JAGUARAVI/STMProject/hardware/README.md

# ESWCap Rev C.1 hardware

This directory contains the KiCad source for the Rev C carrier with the
accuracy-plan changes applied (**Rev C.1**, see `docs/accuracy-plan.md`):
USB-only power, 3.3 V relays, true 4-wire C/R, the corrected J8 bias header,
and the H1–H6 accuracy changes.

## Status (2026-11-13)

- **Schematic:** Rev C + accuracy plan H1–H6. ERC-clean (0 errors, 0 warnings).
  - H1 J2-13 (PA7, OPAMP1 sense) moved FL → `MUXR_COM`
  - H2 `MUXR_EN` moved J2-17 (PB2) → J1-17 (PB15)
  - H3 `VBUF` also on J2-17 (PB2, OPAMP3 VINM0) for the PGA stage
  - H4 R20 100k → 1k; H5 D1 BAT54S → BAV199; H6 R33 1M → 10M
  - PWR_FLAGs excluded from BOM/board
- **PCB:** `kicad/Project.kicad_pcb`, 111 × 85 mm, 2 layers, **fully routed**.
  DRC: 0 unconnected, 0 clearance/short/hole errors, schematic parity clean;
  45 silkscreen-only warnings. Critical analog nets are hand-routed and locked;
  the rest is Freerouting + targeted fixes. How it was built:
  `scripts/README.md`.
  - Ground: B.Cu plane + F.Cu pour, stitched by ~318 vias, with **no-pour
    cutouts** under J5/SH divider/U9/U10, the VCAP node, and the TIA input (P2)
  - TIA guard: F.Cu `VBIAS` pour around the U1A summing node (P1)
  - Footprint fixes: C1 and J5/J6 courtyards/silkscreen now match the real
    bodies (they were drawn around the pads only)
- **Fab outputs:** `fab/Project-gerbers.zip` (`fab/gerbers/`), drill + map,
  `fab/Project-pos.csv`, `fab/Project-bom.csv`, schematic PDF/SVG,
  `fab/Project-pcb-front.pdf` / `-back.pdf`, `fab/Project-3d-top.png`.
  **Not yet reviewed by a person — review before ordering.**
- `wip/Project-revC-routing-baseline.kicad_pcb` is the old pre-review baseline,
  kept for reference only. Do not fabricate it.

Open `kicad/Project.kicad_pro` with KiCad 10. The project-local libraries
(`eswcap.kicad_sym`, `eswcap.pretty/`) are included; the schematic will not
resolve symbols/footprints without them.

## Rev C circuit summary

- **Power:** USB-C VBUS → module D4 → VDD5V → module ME6231A33M3G LDO → +3.3 V.
  J3-3/4 (`VDD5V`) are NC on the carrier. No 5 V carrier rail. Only Vbias
  (0–20 V) is external, on J6.
- **Relays:** K1/K2 = Omron **G6S-2 DC3** (3 V coils) on +3.3 V. D4/D5
  flyback cathodes, C10/C15, and coil high side are on +3V3.
- **DUT:** J5 is 4-pin, ordered **FH, SH, SL, FL**. R-mode is true 4-wire
  Kelvin; `SL` has a 100 kΩ series resistor (R40) into U1B.
- **C-mode 4-terminal sense:** 10 M/1 M divider on `SH` (R38/R39), compensated
  by C21 10 pF across the top leg and C20 100 pF across the bottom leg. The
  divider is buffered by the **internal STM32 OPAMP3** (no second LMC6482).
  U9 isolates the `SH → R20 → VN_SENSE` branch when K1 is off; U10 connects
  `SH_DIV` to `VN_SENSE` when K1 is off. U10 is controlled by PC4
  (`C_MODE_SW`, active low).
- **R20 / D2:** R20 = 100 kΩ; D2 = BAV199 (low-leakage clamp).
- **J8 bias-control header:**

| Pin | Signal | Module pin | Note |
| --- | --- | --- | --- |
| 1 | `BIAS_SET` | PA4 / J2-10 | TIM3_CH2 PWM, R34 1 k + C16 10 µF |
| 2 | `BIAS_EN` | PA15 / J1-10 | GPIO, R35 10 k pulldown |
| 3 | `BIAS_MON` | **PA8 / J1-15** | ADC5_IN1, R36 1 k + C17 100 nF |
| 4 | GND | — | — |
| 5 | `+3V3` | J4 | future module <50 mA |
| 6 | `BIAS_UART_TX` | PC10 / J1-9 | USART3_TX |
| 7 | `BIAS_UART_RX` | PC11 / J1-8 | USART3_RX |
| 8 | GND | — | — |

- **PA0 is `DRIVE` / COMP1_OUT** (firmware fix of 2026-11-12). PA8 is now free
  and carries `BIAS_MON`. PC4 is the U10 control output.
- **J5 pin order:** 1 FH, 2 SH, 3 SL, 4 FL. Use 1–2 and 3–4 links for a 2-wire
  DUT.

## BOM

`fab/Project-bom.csv` is generated from the schematic. It contains 88 physical
parts, 46 grouped lines and 3 PWR_FLAGs. The only new orderable part type is
J8 (1×8 2.54 mm header) and J5 (4-pin 5.08 mm terminal block); K1/K2 are
G6S-2 DC3. See the CSV for the complete list.

## What is deliberately not here

- The second LMC6482 was removed: it is not available. The C-mode SH divider
  now uses the internal OPAMP3.
- The PCB is not final. It must be regenerated and rerouted after the
  schematic is frozen. The WIP baseline has the pre-U9/U10 netlist and must
  not be fabricated.
- The OLED/button additions proposed in the integration-plan review are not
  part of this revision.
