JAGUARAVI/STMProject/docs/circuit/ESWCap-circuit-diagrams.pdf

# 68nF 1 2 C1

# J2 WeAct P2

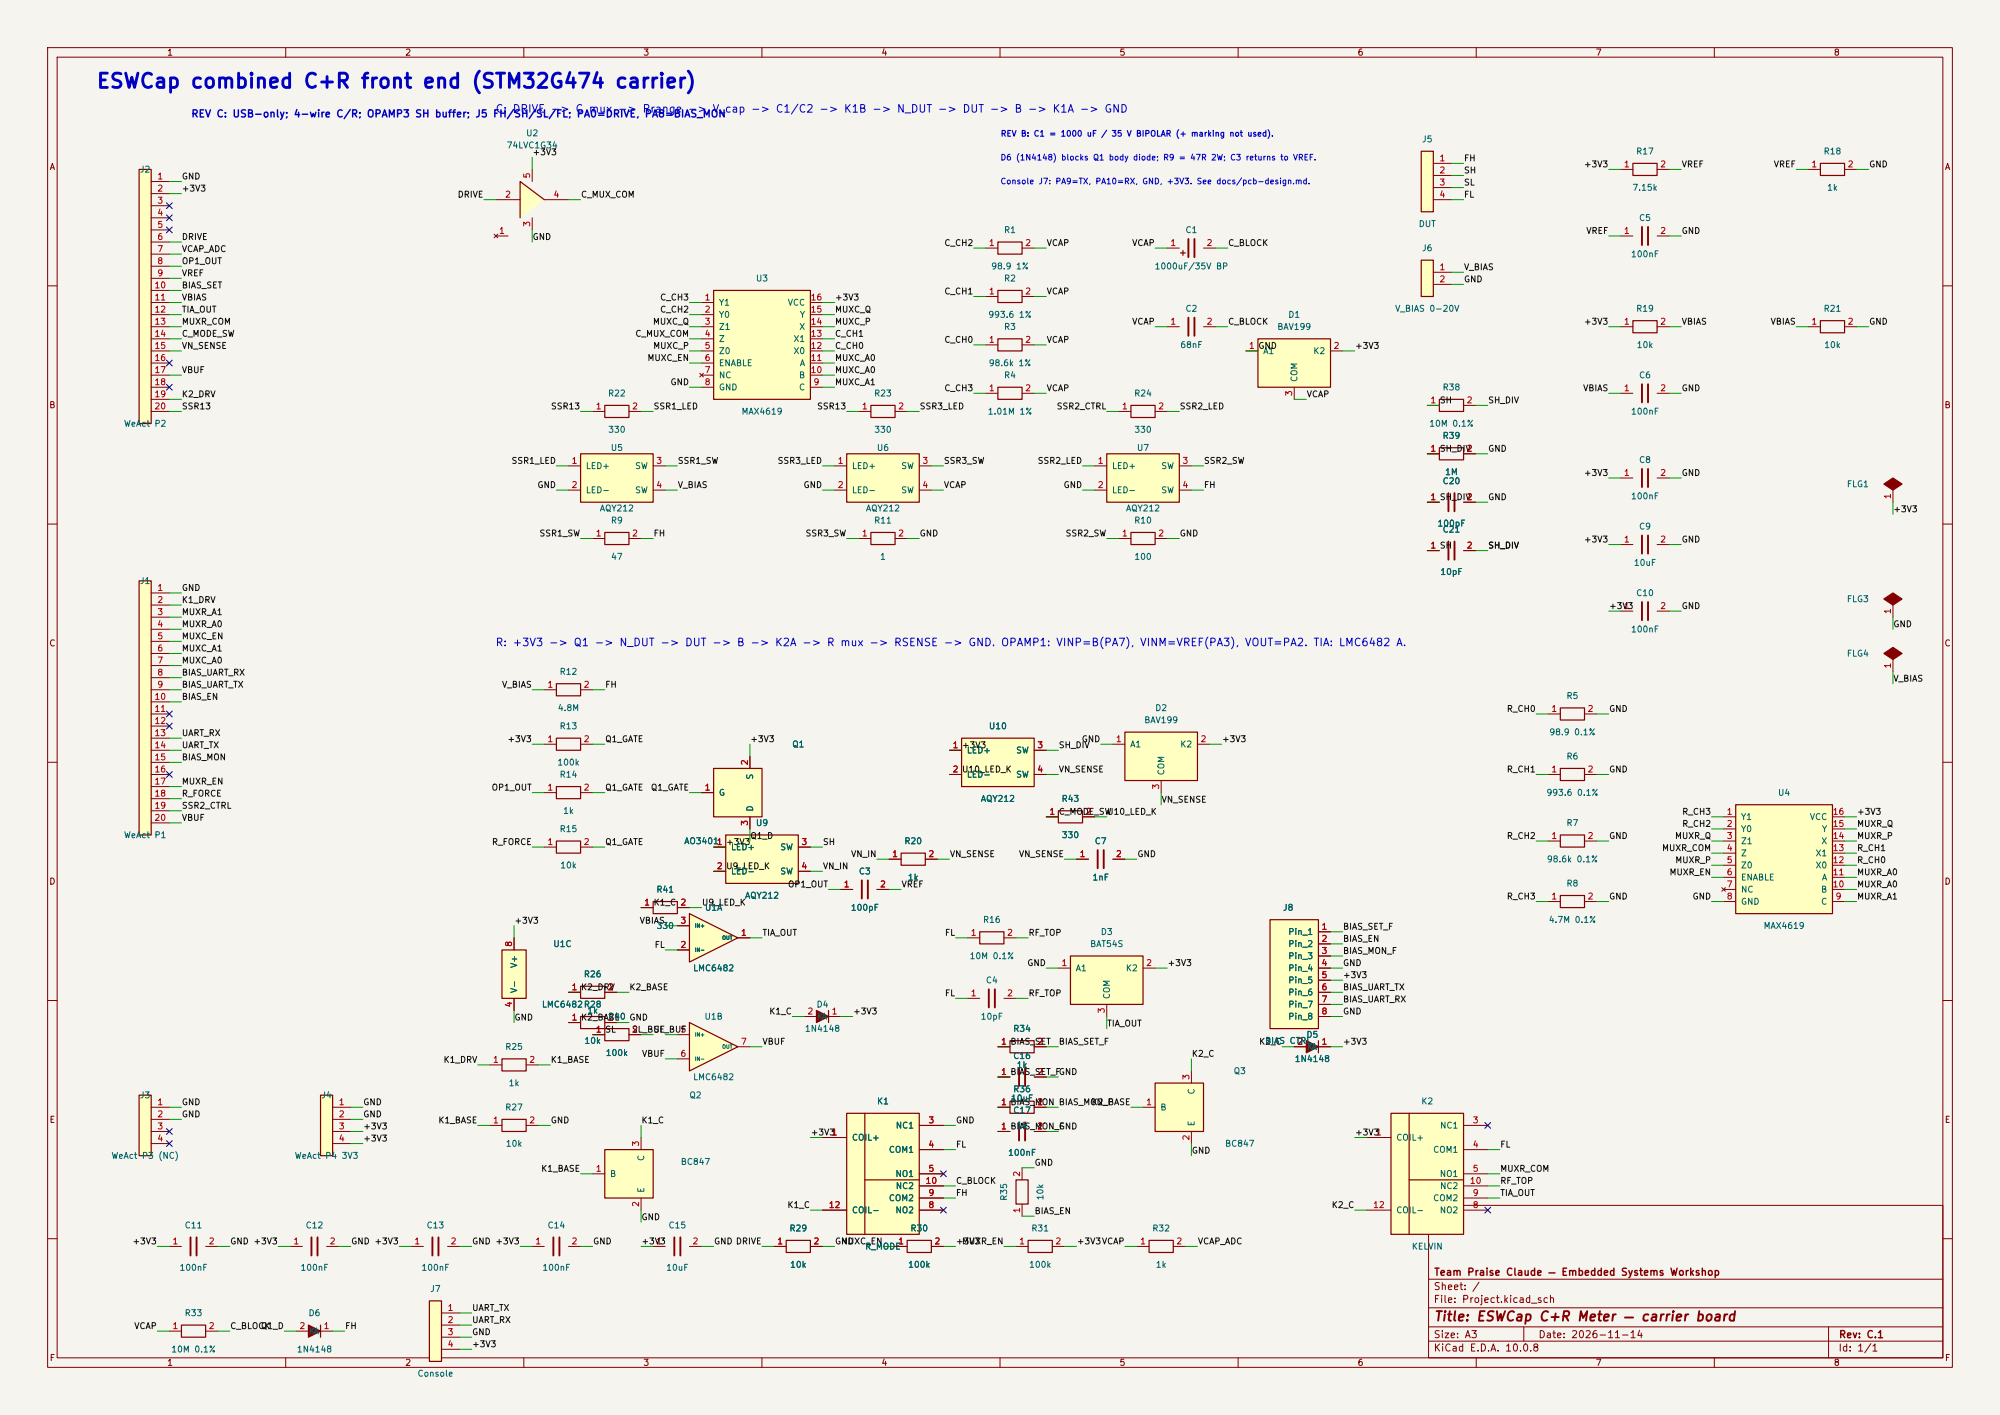
[picture p1: page 7]

ESWCap combined C+R front end (STM32G474 carrier)

REV C: USB-only; 4-wire C/R; OPAMP3 SH buffer; J5 FH/SH/SL/FL; PA0=DRIVE, PA8=BIAS_MON

C: DRIVE -> C mux -> Rrange -> V_cap -> C1/C2 -> K1B -> N_DUT -> DUT -> B -> K1A -> GND

Console J7: PA9=TX, PA10=RX, GND, +3V3. See docs/pcb-design.md. D6 (1N4148) blocks Q1 body diode; R9 = 47R 2W; C3 returns to VREF. REV B: C1 = 1000 uF / 35 V BIPOLAR (+ marking not used).

SSR3_LED MUXC_A1 R: +3V3 -> Q1 -> N_DUT -> DUT -> B -> K2A -> R mux -> RSENSE -> GND. OPAMP1: VINP=B(PA7), VINM=VREF(PA3), VOUT=PA2. TIA: LMC6482 A.

Team Praise Claude — Embedded Systems Workshop
Sheet: /
File: Project.kicad_sch
Title: ESWCap C+R Meter — carrier board
KiCad E.D.A. 10.0.8
