JAGUARAVI/STMProject/hardware/fab/Project-3d-top.png

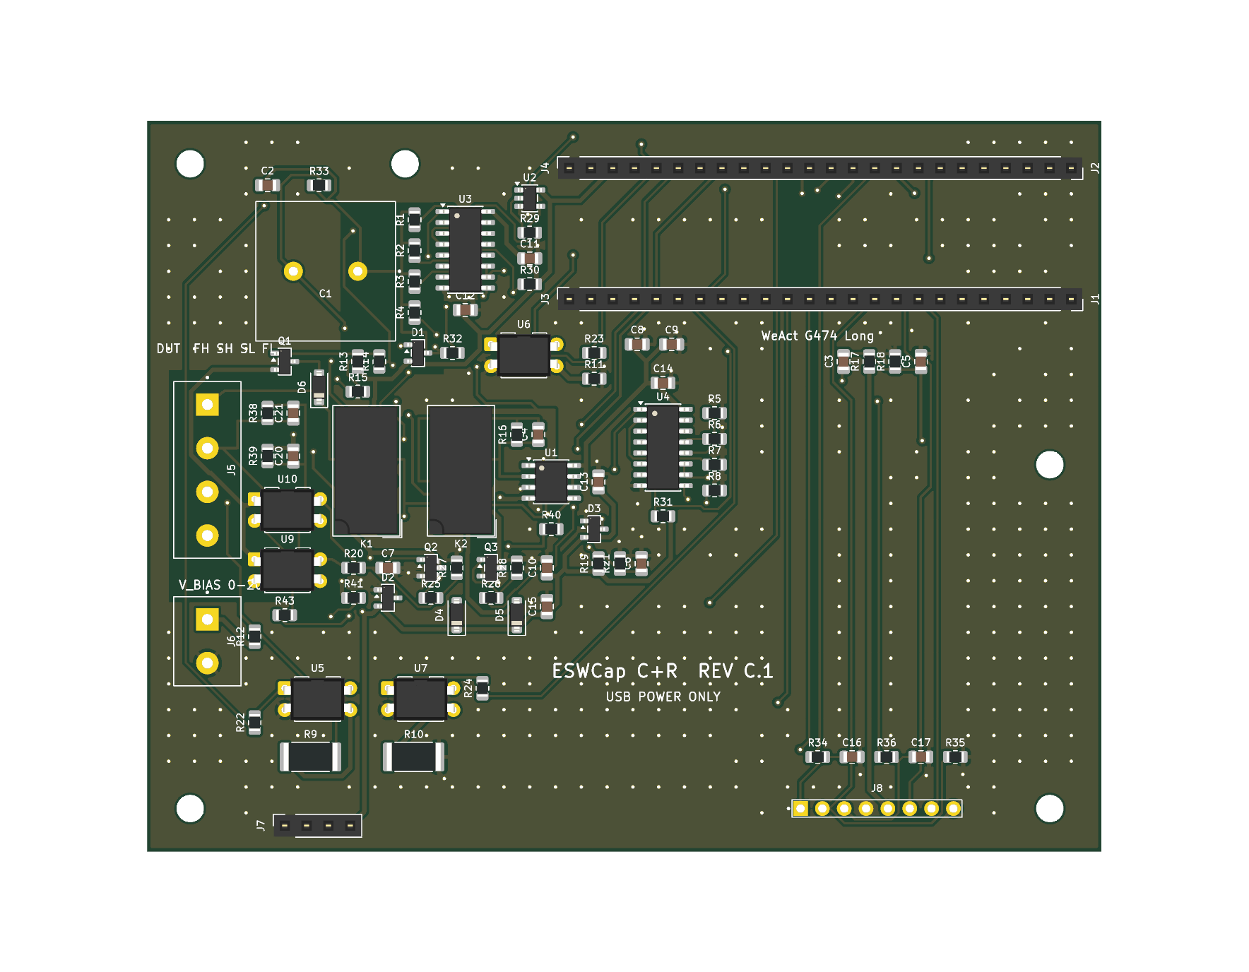
hardware/fab/Project-3d-top.png
