JAGUARAVI/STMProject/hardware/fab/Project-bom.csv

Refs | Value | Footprint | MPN | Qty
C1 | 1000uF/35V BP | eswcap:C_Radial_D16_P7.5 |  | 1
C2 | 68nF | eswcap:C_0805_2012Metric |  | 1
C3,C20 | 100pF | eswcap:C_0805_2012Metric |  | 2
C4,C21 | 10pF | eswcap:C_0805_2012Metric |  | 2
C5,C6,C8,C10-C14,C17 | 100nF | eswcap:C_0805_2012Metric |  | 9
C7 | 1nF | eswcap:C_0805_2012Metric |  | 1
C9,C15,C16 | 10uF | eswcap:C_0805_2012Metric |  | 3
D1,D2 | BAV199 | eswcap:SOT-23 |  | 2
D3 | BAT54S | eswcap:SOT-23 |  | 1
D4-D6 | 1N4148 | eswcap:D_SOD-123 |  | 3
J1 | WeAct P1 | eswcap:PinSocket_1x20_P2.54mm_Vertical |  | 1
J2 | WeAct P2 | eswcap:PinSocket_1x20_P2.54mm_Vertical |  | 1
J3 | WeAct P3 (NC) | eswcap:PinSocket_1x04_P2.54mm_Vertical |  | 1
J4 | WeAct P4 3V3 | eswcap:PinSocket_1x04_P2.54mm_Vertical |  | 1
J5 | DUT | eswcap:TerminalBlock_4P_5.08 |  | 1
J6 | V_BIAS 0-20V | eswcap:TerminalBlock_2P_5.08 |  | 1
J7 | Console | eswcap:PinSocket_1x04_P2.54mm_Vertical |  | 1
J8 | BIAS CTRL | eswcap:PinHeader_1x08_P2.54mm_Vertical |  | 1
K1 | R_MODE | eswcap:Relay_DPDT_Omron_G6S-2 | G6S-2 DC3 | 1
K2 | KELVIN | eswcap:Relay_DPDT_Omron_G6S-2 | G6S-2 DC3 | 1
Q1 | AO3401 | eswcap:SOT-23 |  | 1
Q2,Q3 | BC847 | eswcap:SOT-23 |  | 2
R1 | 98.9 1% | eswcap:R_0805_2012Metric |  | 1
R2 | 993.6 1% | eswcap:R_0805_2012Metric |  | 1
R3 | 98.6k 1% | eswcap:R_0805_2012Metric |  | 1
R4 | 1.01M 1% | eswcap:R_0805_2012Metric |  | 1
R5 | 98.9 0.1% | eswcap:R_0805_2012Metric |  | 1
R6 | 993.6 0.1% | eswcap:R_0805_2012Metric |  | 1
R7 | 98.6k 0.1% | eswcap:R_0805_2012Metric |  | 1
R8 | 4.7M 0.1% | eswcap:R_0805_2012Metric |  | 1
R9 | 47 | eswcap:R_2512_6332Metric |  | 1
R10 | 100 | eswcap:R_2512_6332Metric |  | 1
R11 | 1 | eswcap:R_0805_2012Metric |  | 1
R12 | 4.8M | eswcap:R_0805_2012Metric |  | 1
R13,R30,R31,R40 | 100k | eswcap:R_0805_2012Metric |  | 4
R14,R18,R20,R25,R26,R32,R34,R36 | 1k | eswcap:R_0805_2012Metric |  | 8
R15,R19,R21,R27-R29,R35 | 10k | eswcap:R_0805_2012Metric |  | 7
R16,R33,R38 | 10M 0.1% | eswcap:R_0805_2012Metric |  | 3
R17 | 7.15k | eswcap:R_0805_2012Metric |  | 1
R22-R24,R41,R43 | 330 | eswcap:R_0805_2012Metric |  | 5
R39 | 1M | eswcap:R_0805_2012Metric |  | 1
U1 | LMC6482 | eswcap:SOIC-8_3.9x4.9mm_P1.27mm |  | 1
U2 | 74LVC1G34 | eswcap:SOT-23-5 |  | 1
U3,U4 | MAX4619 | eswcap:SOIC-16_3.9x9.9mm_P1.27mm |  | 2
U5-U7,U9,U10 | AQY212 | eswcap:DIP-4_W7.62mm |  | 5
