JAGUARAVI/STMProject/docs/build/ESWCap-wire-list.csv

Wire | Block | Net | From | To | Length on PCB (mm) | Keep short (sensitive analog) | Done
1 | Power, relays & control | BIAS_EN | J1-10 | R35-1 | 53.9
2 | Power, relays & control | BIAS_EN | R35-1 | J8-2 | 15.7
3 | Power, relays & control | BIAS_MON | J1-15 | R36-1 | 54.9
4 | Power, relays & control | BIAS_MON_F | C17-1 | R36-2 | 2.1
5 | Power, relays & control | BIAS_MON_F | R36-2 | J8-3 | 8.4
6 | Power, relays & control | BIAS_SET | J2-10 | R34-1 | 68.9
7 | Power, relays & control | BIAS_SET_F | C16-1 | R34-2 | 2.1
8 | Power, relays & control | BIAS_SET_F | R34-2 | J8-1 | 6.7
9 | Power, relays & control | BIAS_UART_RX | J1-8 | J8-7 | 59.3
10 | Power, relays & control | BIAS_UART_TX | J1-9 | J8-6 | 59.3
11 | Power, relays & control | K1_BASE | Q2-1 | R27-1 | 4.4
12 | Power, relays & control | K1_BASE | R27-1 | R25-2 | 3.3
13 | Power, relays & control | K1_C | D4-2 | Q2-3 | 4.4
14 | Power, relays & control | K1_C | Q2-3 | R41-1 | 11.4
15 | Power, relays & control | K1_C | R41-1 | K1-12 | 8.5
16 | Power, relays & control | K1_DRV | J1-2 | R25-1 | 80.7
17 | Power, relays & control | K2_BASE | Q3-1 | R28-1 | 4.4
18 | Power, relays & control | K2_BASE | R28-1 | R26-2 | 3.3
19 | Power, relays & control | K2_C | D5-2 | Q3-3 | 4.4
20 | Power, relays & control | K2_C | Q3-3 | K2-12 | 8.6
21 | Power, relays & control | K2_DRV | J2-19 | R26-1 | 54.9
22 | Power, relays & control | UART_RX | J1-13 | J7-2 | 84.7
23 | Power, relays & control | UART_TX | J1-14 | J7-1 | 84.7
24 | C-mode | C_BLOCK | C1-2 | C2-2 | 10.2 | YES
25 | C-mode | C_BLOCK | C2-2 | R33-2 | 6.0 | YES
26 | C-mode | C_BLOCK | C1-2 | K1-10 | 25.1 | YES
27 | C-mode | C_CH0 | R3-1 | U3-12 | 9.3
28 | C-mode | C_CH1 | R2-1 | U3-13 | 8.5
29 | C-mode | C_CH2 | R1-1 | U3-2 | 3.5
30 | C-mode | C_CH3 | R4-1 | U3-1 | 13.1
31 | C-mode | C_MUX_COM | U2-4 | U3-4 | 12.0
32 | C-mode | DRIVE | J2-6 | U2-2 | 51.6
33 | C-mode | DRIVE | U2-2 | R29-1 | 4.0
34 | C-mode | MUXC_A0 | J1-7 | U3-10 | 52.8
35 | C-mode | MUXC_A0 | U3-10 | U3-11 | 1.3
36 | C-mode | MUXC_A1 | J1-6 | U3-9 | 55.3
37 | C-mode | MUXC_EN | J1-5 | R30-1 | 53.8
38 | C-mode | MUXC_EN | R30-1 | U3-6 | 9.3
39 | C-mode | MUXC_P | U3-14 | U3-5 | 5.6
40 | C-mode | MUXC_Q | U3-15 | U3-3 | 5.1
41 | C-mode | VCAP | C1-1 | R3-2 | 6.6 | YES
42 | C-mode | VCAP | R3-2 | R4-2 | 3.6 | YES
43 | C-mode | VCAP | R3-2 | R2-2 | 3.6 | YES
44 | C-mode | VCAP | R2-2 | R1-2 | 3.6 | YES
45 | C-mode | VCAP | R4-2 | D1-3 | 5.8 | YES
46 | C-mode | VCAP | D1-3 | R32-1 | 2.1 | YES
47 | C-mode | VCAP | C1-1 | R33-1 | 11.4 | YES
48 | C-mode | VCAP | R33-1 | C2-1 | 6.0 | YES
49 | C-mode | VCAP | R32-1 | U6-4 | 13.1 | YES
50 | C-mode | VCAP_ADC | J2-7 | R32-2 | 59.8
51 | Bias & safety | C_MODE_SW | J2-14 | R43-1 | 78.9
52 | Bias & safety | FH | D6-1 | K1-9 | 7.3 | YES
53 | Bias & safety | FH | D6-1 | J5-1 | 13.0 | YES
54 | Bias & safety | FH | K1-9 | R12-2 | 22.3 | YES
55 | Bias & safety | FH | R12-2 | R9-2 | 17.7 | YES
56 | Bias & safety | FH | R9-2 | U7-4 | 15.8 | YES
57 | Bias & safety | SH_DIV | C20-1 | R39-1 | 3.0 | YES
58 | Bias & safety | SH_DIV | R39-1 | R38-2 | 6.8 | YES
59 | Bias & safety | SH_DIV | R38-2 | C21-2 | 3.0 | YES
60 | Bias & safety | SH_DIV | C20-1 | U10-3 | 7.3 | YES
61 | Bias & safety | SSR13 | J2-20 | R23-1 | 23.0
62 | Bias & safety | SSR13 | R23-1 | R22-1 | 58.5
63 | Bias & safety | SSR1_LED | R22-2 | U5-1 | 4.7
64 | Bias & safety | SSR1_SW | R9-1 | U5-3 | 9.3
65 | Bias & safety | SSR2_CTRL | J1-19 | R24-1 | 51.5
66 | Bias & safety | SSR2_LED | R24-2 | U7-1 | 11.0
67 | Bias & safety | SSR2_SW | R10-1 | U7-3 | 9.3
68 | Bias & safety | SSR3_LED | R23-2 | U6-1 | 13.0
69 | Bias & safety | SSR3_SW | R11-1 | U6-3 | 3.8
70 | Bias & safety | U10_LED_K | R43-2 | U10-2 | 11.8
71 | Bias & safety | V_BIAS | J6-1 | R12-1 | 6.2
72 | Bias & safety | V_BIAS | R12-1 | U5-4 | 12.2
73 | R-mode Kelvin | MUXR_A0 | J1-4 | U4-11 | 42.0
74 | R-mode Kelvin | MUXR_A0 | U4-11 | U4-10 | 1.3
75 | R-mode Kelvin | MUXR_A1 | J1-3 | U4-9 | 45.5
76 | R-mode Kelvin | MUXR_COM | J2-13 | U4-4 | 37.4 | YES
77 | R-mode Kelvin | MUXR_COM | U4-4 | K2-5 | 18.5 | YES
78 | R-mode Kelvin | MUXR_EN | J1-17 | U4-6 | 21.3
79 | R-mode Kelvin | MUXR_EN | U4-6 | R31-1 | 6.3
80 | R-mode Kelvin | MUXR_P | U4-14 | U4-5 | 5.6
81 | R-mode Kelvin | MUXR_Q | U4-15 | U4-3 | 5.1
82 | R-mode Kelvin | OP1_OUT | C3-1 | J2-8 | 25.0
83 | R-mode Kelvin | OP1_OUT | C3-1 | R14-1 | 54.0
84 | R-mode Kelvin | Q1_D | D6-2 | Q1-3 | 3.3
85 | R-mode Kelvin | Q1_GATE | Q1-1 | R13-2 | 9.4
86 | R-mode Kelvin | Q1_GATE | R13-2 | R14-2 | 2.5
87 | R-mode Kelvin | Q1_GATE | R13-2 | R15-2 | 4.5
88 | R-mode Kelvin | R_CH0 | R5-1 | U4-12 | 5.3
89 | R-mode Kelvin | R_CH1 | R6-1 | U4-13 | 2.6
90 | R-mode Kelvin | R_CH2 | R7-1 | U4-2 | 9.2
91 | R-mode Kelvin | R_CH3 | R8-1 | U4-1 | 12.1
92 | R-mode Kelvin | R_FORCE | J1-18 | R15-1 | 42.1
93 | R-mode Kelvin | SH | C21-1 | R38-1 | 3.0 | YES
94 | R-mode Kelvin | SH | R38-1 | J5-2 | 7.7 | YES
95 | R-mode Kelvin | SH | C21-1 | U9-3 | 18.8 | YES
96 | R-mode Kelvin | SL | J5-3 | R40-1 | 39.3 | YES
97 | R-mode Kelvin | SL_BUF | R40-2 | U1-5 | 3.9 | YES
98 | R-mode Kelvin | U9_LED_K | R41-2 | U9-2 | 12.6
99 | R-mode Kelvin | VBUF | J1-20 | J2-17 | 17.0
100 | R-mode Kelvin | VBUF | J1-20 | U1-7 | 22.8
101 | R-mode Kelvin | VBUF | U1-7 | U1-6 | 1.3
102 | R-mode Kelvin | VN_IN | R20-1 | U9-4 | 3.1 | YES
103 | R-mode Kelvin | VN_SENSE | C7-1 | R20-2 | 2.1 | YES
104 | R-mode Kelvin | VN_SENSE | C7-1 | D2-3 | 4.0 | YES
105 | R-mode Kelvin | VN_SENSE | R20-2 | U10-4 | 9.3 | YES
106 | R-mode Kelvin | VN_SENSE | U10-4 | J2-15 | 64.6 | YES
107 | R-mode Kelvin | VREF | C3-2 | R17-2 | 3.0
108 | R-mode Kelvin | VREF | R17-2 | R18-1 | 3.5
109 | R-mode Kelvin | VREF | R18-1 | C5-1 | 3.0
110 | R-mode Kelvin | VREF | R17-2 | J2-9 | 21.8
111 | R-mode TIA | FL | C4-1 | R16-1 | 2.5 | YES
112 | R-mode TIA | FL | C4-1 | U1-2 | 4.0 | YES
113 | R-mode TIA | FL | R16-1 | K2-4 | 4.5 | YES
114 | R-mode TIA | FL | K2-4 | K1-4 | 11.0 | YES
115 | R-mode TIA | FL | K1-4 | J5-4 | 22.8 | YES
116 | R-mode TIA | RF_TOP | C4-2 | R16-2 | 2.5 | YES
117 | R-mode TIA | RF_TOP | R16-2 | K2-10 | 11.1 | YES
118 | R-mode TIA | TIA_OUT | D3-3 | U1-1 | 11.2
119 | R-mode TIA | TIA_OUT | U1-1 | K2-9 | 10.6
120 | R-mode TIA | TIA_OUT | U1-1 | J2-12 | 49.2
121 | R-mode TIA | VBIAS | C6-1 | R21-1 | 2.5 | YES
122 | R-mode TIA | VBIAS | R21-1 | R19-2 | 3.1 | YES
123 | R-mode TIA | VBIAS | R19-2 | U1-3 | 11.3 | YES
124 | R-mode TIA | VBIAS | U1-3 | J2-11 | 52.8 | YES
 | Rail | GND | C10-2 | GND rail
 | Rail | GND | C11-2 | GND rail
 | Rail | GND | C12-2 | GND rail
 | Rail | GND | C13-2 | GND rail
 | Rail | GND | C14-2 | GND rail
 | Rail | GND | C15-2 | GND rail
 | Rail | GND | C16-2 | GND rail
 | Rail | GND | C17-2 | GND rail
 | Rail | GND | C20-2 | GND rail
 | Rail | GND | C5-2 | GND rail
 | Rail | GND | C6-2 | GND rail
 | Rail | GND | C7-2 | GND rail
 | Rail | GND | C8-2 | GND rail
 | Rail | GND | C9-2 | GND rail
 | Rail | GND | D1-1 | GND rail
 | Rail | GND | D2-1 | GND rail
 | Rail | GND | D3-1 | GND rail
 | Rail | GND | J1-1 | GND rail
 | Rail | GND | J2-1 | GND rail
 | Rail | GND | J3-1 | GND rail
 | Rail | GND | J3-2 | GND rail
 | Rail | GND | J4-1 | GND rail
 | Rail | GND | J4-2 | GND rail
 | Rail | GND | J6-2 | GND rail
 | Rail | GND | J7-3 | GND rail
 | Rail | GND | J8-4 | GND rail
 | Rail | GND | J8-8 | GND rail
 | Rail | GND | K1-3 | GND rail
 | Rail | GND | Q2-2 | GND rail
 | Rail | GND | Q3-2 | GND rail
 | Rail | GND | R10-2 | GND rail
 | Rail | GND | R11-2 | GND rail
 | Rail | GND | R18-2 | GND rail
 | Rail | GND | R21-2 | GND rail
 | Rail | GND | R27-2 | GND rail
 | Rail | GND | R28-2 | GND rail
 | Rail | GND | R29-2 | GND rail
 | Rail | GND | R35-2 | GND rail
 | Rail | GND | R39-2 | GND rail
 | Rail | GND | R5-2 | GND rail
 | Rail | GND | R6-2 | GND rail
 | Rail | GND | R7-2 | GND rail
 | Rail | GND | R8-2 | GND rail
 | Rail | GND | U1-4 | GND rail
 | Rail | GND | U2-3 | GND rail
 | Rail | GND | U3-8 | GND rail
 | Rail | GND | U4-8 | GND rail
 | Rail | GND | U5-2 | GND rail
 | Rail | GND | U6-2 | GND rail
 | Rail | GND | U7-2 | GND rail
 | Rail | +3V3 | C10-1 | +3V3 rail
 | Rail | +3V3 | C11-1 | +3V3 rail
 | Rail | +3V3 | C12-1 | +3V3 rail
 | Rail | +3V3 | C13-1 | +3V3 rail
 | Rail | +3V3 | C14-1 | +3V3 rail
 | Rail | +3V3 | C15-1 | +3V3 rail
 | Rail | +3V3 | C8-1 | +3V3 rail
 | Rail | +3V3 | C9-1 | +3V3 rail
 | Rail | +3V3 | D1-2 | +3V3 rail
 | Rail | +3V3 | D2-2 | +3V3 rail
 | Rail | +3V3 | D3-2 | +3V3 rail
 | Rail | +3V3 | D4-1 | +3V3 rail
 | Rail | +3V3 | D5-1 | +3V3 rail
 | Rail | +3V3 | J2-2 | +3V3 rail
 | Rail | +3V3 | J4-3 | +3V3 rail
 | Rail | +3V3 | J4-4 | +3V3 rail
 | Rail | +3V3 | J7-4 | +3V3 rail
 | Rail | +3V3 | J8-5 | +3V3 rail
 | Rail | +3V3 | K1-1 | +3V3 rail
 | Rail | +3V3 | K2-1 | +3V3 rail
 | Rail | +3V3 | Q1-2 | +3V3 rail
 | Rail | +3V3 | R13-1 | +3V3 rail
 | Rail | +3V3 | R17-1 | +3V3 rail
 | Rail | +3V3 | R19-1 | +3V3 rail
 | Rail | +3V3 | R30-2 | +3V3 rail
 | Rail | +3V3 | R31-2 | +3V3 rail
 | Rail | +3V3 | U1-8 | +3V3 rail
 | Rail | +3V3 | U10-1 | +3V3 rail
 | Rail | +3V3 | U2-5 | +3V3 rail
 | Rail | +3V3 | U3-16 | +3V3 rail
 | Rail | +3V3 | U4-16 | +3V3 rail
 | Rail | +3V3 | U9-1 | +3V3 rail
