JAGUARAVI/STMProject/hardware/fab/Project-pcb-back.pdf

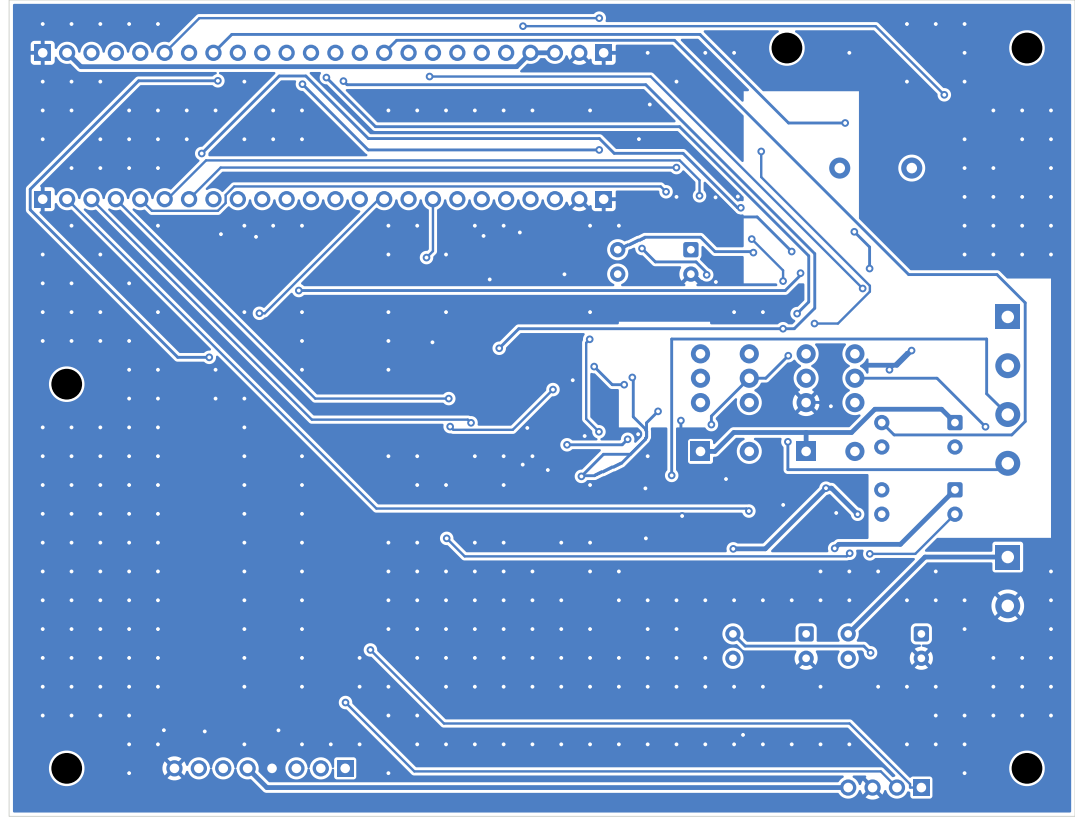
[picture p10: page 1]
