JAGUARAVI/STMProject/hardware/fab/Project-pcb-front.pdf

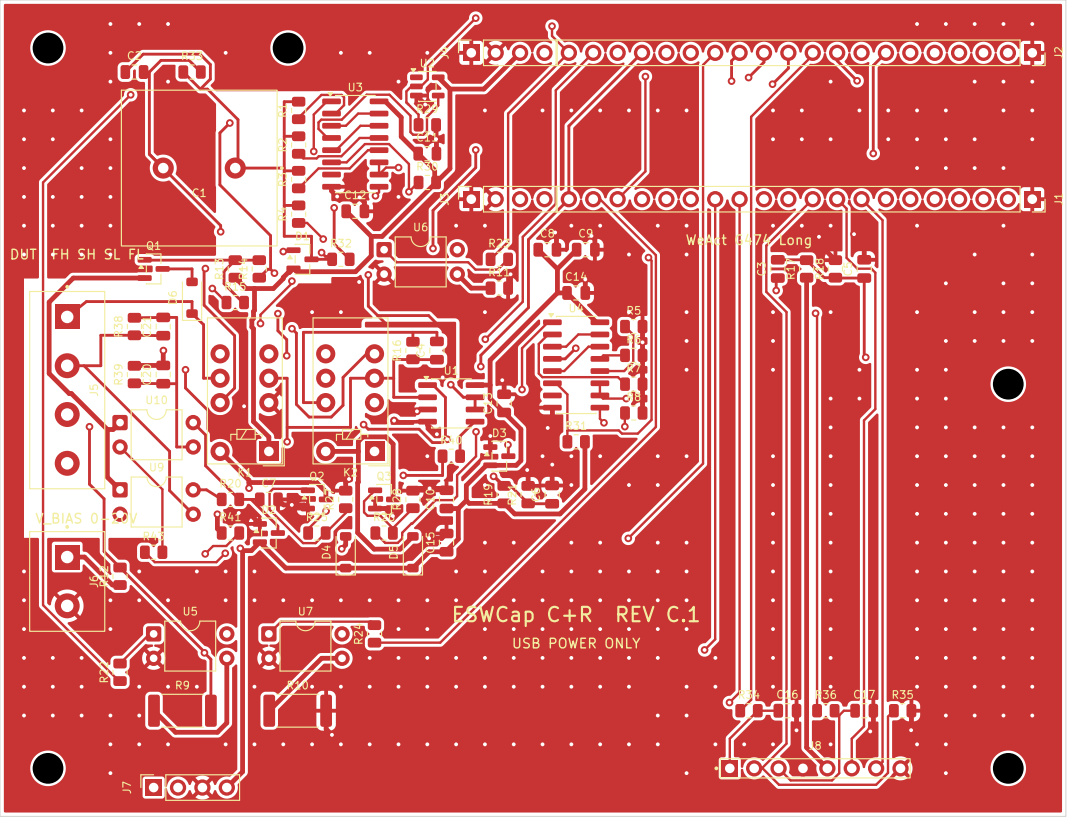
[picture p11: page 1]
