JAGUARAVI/STMProject/hardware/kicad/Project.kicad_pcb

## KiCad design hardware/kicad/Project.kicad_pcb (2026-11-14)

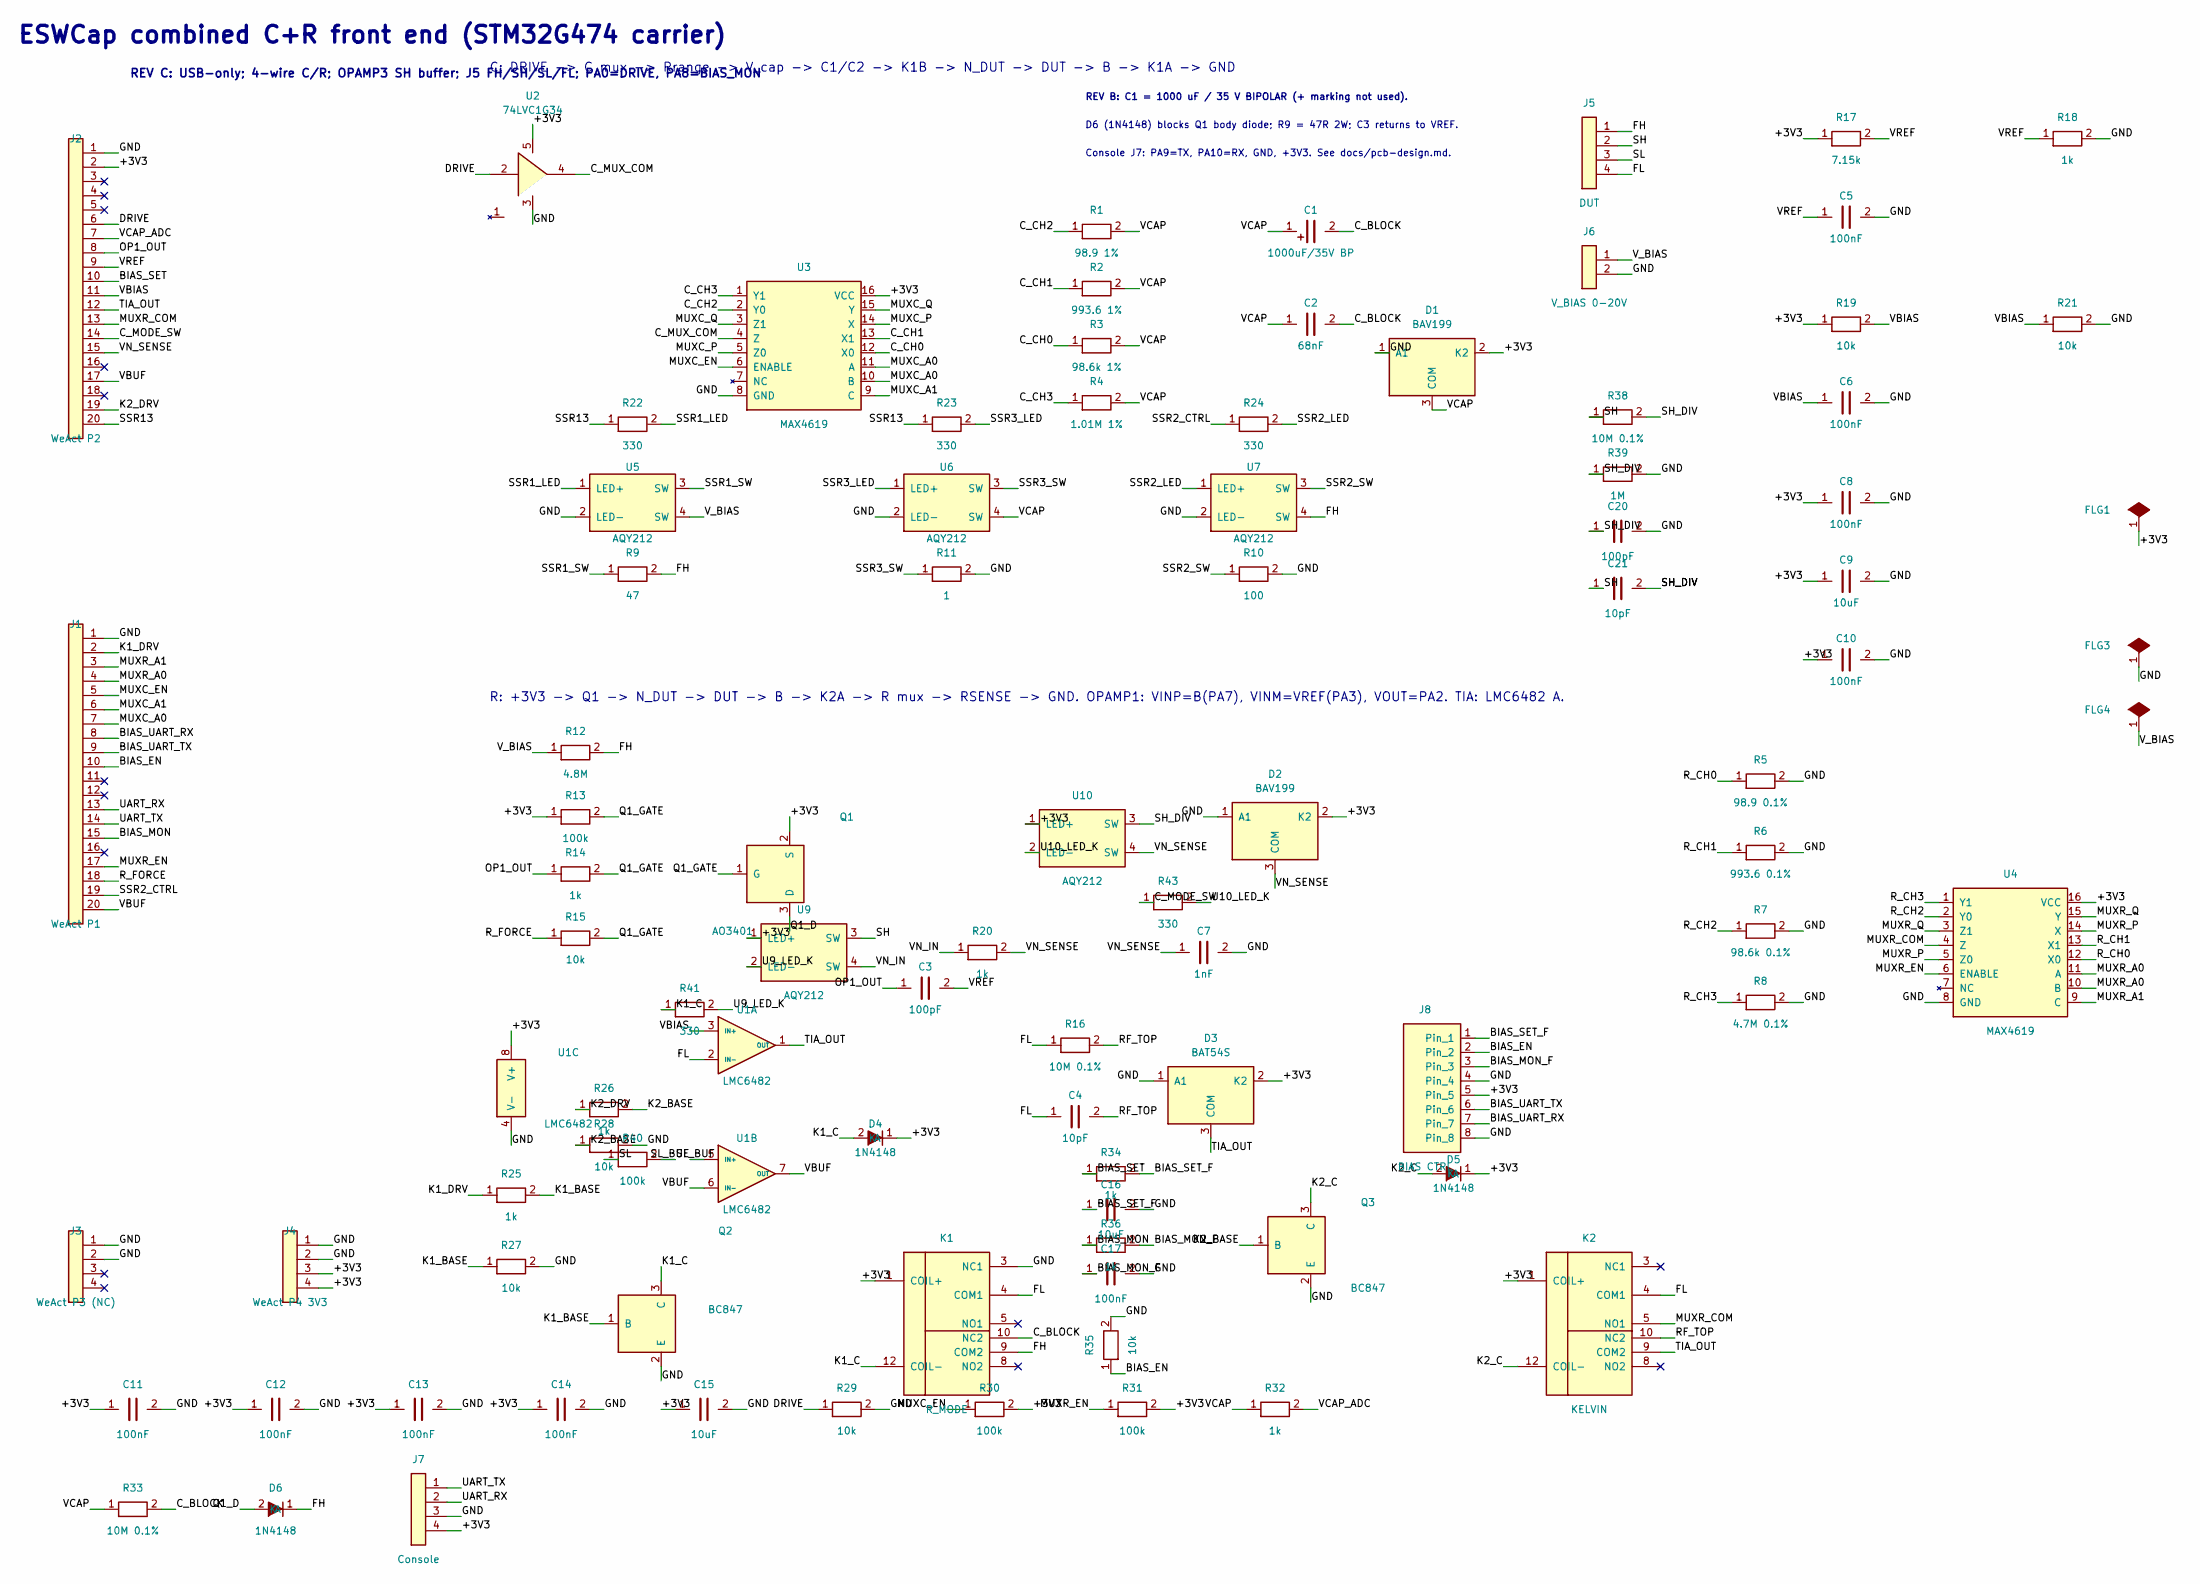
[picture p12: schematic Project.kicad_sch, ESWCap C+R Meter — carrier board]

Parts:
C1: 1000uF/35V BP; C_Radial_D16_P7.5
C2: 68nF; C_0805_2012Metric
C3, C20: 100pF; C_0805_2012Metric
C4, C21: 10pF; C_0805_2012Metric
C5, C6, C8, C10, C11, C12, C13, C14, C17: 100nF; C_0805_2012Metric
C7: 1nF; C_0805_2012Metric
C9, C15, C16: 10uF; C_0805_2012Metric
D1, D2: BAV199; SOT-23
D3: BAT54S; SOT-23
D4, D5, D6: 1N4148; D_SOD-123
FLG1, FLG3, FLG4: PWR_FLAG
J1: WeAct P1; PinSocket_1x20_P2.54mm_Vertical
J2: WeAct P2; PinSocket_1x20_P2.54mm_Vertical
J3: WeAct P3 (NC); PinSocket_1x04_P2.54mm_Vertical
J4: WeAct P4 3V3; PinSocket_1x04_P2.54mm_Vertical
J5: DUT; TerminalBlock_4P_5.08
J6: V_BIAS 0-20V; TerminalBlock_2P_5.08
J7: Console; PinSocket_1x04_P2.54mm_Vertical
J8: BIAS CTRL; PinHeader_1x08_P2.54mm_Vertical
K1: R_MODE; Relay_DPDT_Omron_G6S-2; MPN G6S-2 DC3
K2: KELVIN; Relay_DPDT_Omron_G6S-2; MPN G6S-2 DC3
Q1: AO3401; SOT-23
Q2, Q3: BC847; SOT-23
R1: 98.9 1%; R_0805_2012Metric; Tolerance 1%
R2: 993.6 1%; R_0805_2012Metric; Tolerance 1%
R3: 98.6k 1%; R_0805_2012Metric; Tolerance 1%
R4: 1.01M 1%; R_0805_2012Metric; Tolerance 1%
R5: 98.9 0.1%; R_0805_2012Metric; Tolerance 0.1%
R6: 993.6 0.1%; R_0805_2012Metric; Tolerance 0.1%
R7: 98.6k 0.1%; R_0805_2012Metric; Tolerance 0.1%
R8: 4.7M 0.1%; R_0805_2012Metric; Tolerance 0.1%
R9: 47; R_2512_6332Metric
R10: 100; R_2512_6332Metric
R11: 1; R_0805_2012Metric
R12: 4.8M; R_0805_2012Metric
R13, R30, R31, R40: 100k; R_0805_2012Metric
R14, R18, R20, R25, R26, R32, R34, R36: 1k; R_0805_2012Metric
R15, R19, R21, R27, R28, R29, R35: 10k; R_0805_2012Metric
R16: 10M 0.1%; R_0805_2012Metric; Tolerance 0.1%
R17: 7.15k; R_0805_2012Metric
R22, R23, R24, R41, R43: 330; R_0805_2012Metric
R33, R38: 10M 0.1%; R_0805_2012Metric
R39: 1M; R_0805_2012Metric
U1: LMC6482; SOIC-8_3.9x4.9mm_P1.27mm
U2: 74LVC1G34; SOT-23-5
U3, U4: MAX4619; SOIC-16_3.9x9.9mm_P1.27mm
U5, U6, U7, U9, U10: AQY212; DIP-4_W7.62mm

Connections:
/+3V3: C8.1, C9.1, C10.1, C11.1, C12.1, C13.1, C14.1, C15.1, D1.2 (K2), D2.2 (K2), D3.2 (K2), D4.1 (K), D5.1 (K), FLG1.1, J2.2, J4.3, J4.4, J7.4, J8.5, K1.1 (COIL+), K2.1 (COIL+), Q1.2 (S), R13.1, R17.1, R19.1, R30.2, R31.2, U1.8 (V+), U2.5 (VCC), U3.16 (VCC), U4.16 (VCC), U9.1 (LED+), U10.1 (LED+)
/BIAS_EN: J1.10, J8.2, R35.1
/BIAS_MON: J1.15, R36.1
/BIAS_MON_F: C17.1, J8.3, R36.2
/BIAS_SET: J2.10, R34.1
/BIAS_SET_F: C16.1, J8.1, R34.2
/BIAS_UART_RX: J1.8, J8.7
/BIAS_UART_TX: J1.9, J8.6
/C_BLOCK: C1.2 (-), C2.2, K1.10 (NC2), R33.2
/C_CH0: R3.1, U3.12 (X0)
/C_CH1: R2.1, U3.13 (X1)
/C_CH2: R1.1, U3.2 (Y0)
/C_CH3: R4.1, U3.1 (Y1)
/C_MODE_SW: J2.14, R43.1
/C_MUX_COM: U2.4 (Y), U3.4 (Z)
/DRIVE: J2.6, R29.1, U2.2 (A)
/FH: D6.1 (K), J5.1, K1.9 (COM2), R9.2, R12.2, U7.4 (SW)
/FL: C4.1, J5.4, K1.4 (COM1), K2.4 (COM1), R16.1, U1.2 (IN-)
/GND: C5.2, C6.2, C7.2, C8.2, C9.2, C10.2, C11.2, C12.2, C13.2, C14.2, C15.2, C16.2, C17.2, C20.2, D1.1 (A1), D2.1 (A1), D3.1 (A1), FLG3.1, J1.1, J2.1, J3.1, J3.2, J4.1, J4.2, J6.2, J7.3, J8.4, J8.8, K1.3 (NC1), Q2.2 (E), Q3.2 (E), R5.2, R6.2, R7.2, R8.2, R10.2, R11.2, R18.2, R21.2, R27.2, R28.2, R29.2, R35.2, R39.2, U1.4 (V-), U2.3 (GND), U3.8 (GND), U4.8 (GND), U5.2 (LED-), U6.2 (LED-), U7.2 (LED-)
/K1_BASE: Q2.1 (B), R25.2, R27.1
/K1_C: D4.2 (A), K1.12 (COIL-), Q2.3 (C), R41.1
/K1_DRV: J1.2, R25.1
/K2_BASE: Q3.1 (B), R26.2, R28.1
/K2_C: D5.2 (A), K2.12 (COIL-), Q3.3 (C)
/K2_DRV: J2.19, R26.1
/MUXC_A0: J1.7, U3.10 (B), U3.11 (A)
/MUXC_A1: J1.6, U3.9 (C)
/MUXC_EN: J1.5, R30.1, U3.6 (ENABLE)
/MUXC_P: U3.5 (Z0), U3.14 (X)
/MUXC_Q: U3.3 (Z1), U3.15 (Y)
/MUXR_A0: J1.4, U4.10 (B), U4.11 (A)
/MUXR_A1: J1.3, U4.9 (C)
/MUXR_COM: J2.13, K2.5 (NO1), U4.4 (Z)
/MUXR_EN: J1.17, R31.1, U4.6 (ENABLE)
/MUXR_P: U4.5 (Z0), U4.14 (X)
/MUXR_Q: U4.3 (Z1), U4.15 (Y)
/OP1_OUT: C3.1, J2.8, R14.1
/Q1_D: D6.2 (A), Q1.3 (D)
/Q1_GATE: Q1.1 (G), R13.2, R14.2, R15.2
/RF_TOP: C4.2, K2.10 (NC2), R16.2
/R_CH0: R5.1, U4.12 (X0)
/R_CH1: R6.1, U4.13 (X1)
/R_CH2: R7.1, U4.2 (Y0)
/R_CH3: R8.1, U4.1 (Y1)
/R_FORCE: J1.18, R15.1
/SH: C21.1, J5.2, R38.1, U9.3 (SW)
/SH_DIV: C20.1, C21.2, R38.2, R39.1, U10.3 (SW)
/SL: J5.3, R40.1
/SL_BUF: R40.2, U1.5 (IN+)
/SSR1_LED: R22.2, U5.1 (LED+)
/SSR1_SW: R9.1, U5.3 (SW)
/SSR2_CTRL: J1.19, R24.1
/SSR2_LED: R24.2, U7.1 (LED+)
/SSR2_SW: R10.1, U7.3 (SW)
/SSR3_LED: R23.2, U6.1 (LED+)
/SSR3_SW: R11.1, U6.3 (SW)
/SSR13: J2.20, R22.1, R23.1
/TIA_OUT: D3.3 (COM), J2.12, K2.9 (COM2), U1.1 (OUT)
/U9_LED_K: R41.2, U9.2 (LED-)
/U10_LED_K: R43.2, U10.2 (LED-)
/UART_RX: J1.13, J7.2
/UART_TX: J1.14, J7.1
/VBIAS: C6.1, J2.11, R19.2, R21.1, U1.3 (IN+)
/VBUF: J1.20, J2.17, U1.6 (IN-), U1.7 (OUT)
/VCAP: C1.1 (+), C2.1, D1.3 (COM), R1.2, R2.2, R3.2, R4.2, R32.1, R33.1, U6.4 (SW)
/VCAP_ADC: J2.7, R32.2
/VN_IN: R20.1, U9.4 (SW)
/VN_SENSE: C7.1, D2.3 (COM), J2.15, R20.2, U10.4 (SW)
/VREF: C3.2, C5.1, J2.9, R17.2, R18.1
/V_BIAS: FLG4.1, J6.1, R12.1, U5.4 (SW)

Notes on the sheet:
C: DRIVE -> C mux -> Rrange -> V_cap -> C1/C2 -> K1B -> N_DUT -> DUT -> B -> K1A -> GND
R: +3V3 -> Q1 -> N_DUT -> DUT -> B -> K2A -> R mux -> RSENSE -> GND. OPAMP1: VINP=B(PA7), VINM=VREF(PA3), VOUT=PA2. TIA: LMC6482 A.
ESWCap combined C+R front end (STM32G474 carrier)
REV B: C1 = 1000 uF / 35 V BIPOLAR (+ marking not used).
D6 (1N4148) blocks Q1 body diode; R9 = 47R 2W; C3 returns to VREF.
Console J7: PA9=TX, PA10=RX, GND, +3V3. See docs/pcb-design.md.
REV C: USB-only; 4-wire C/R; OPAMP3 SH buffer; J5 FH/SH/SL/FL; PA0=DRIVE, PA8=BIAS_MON

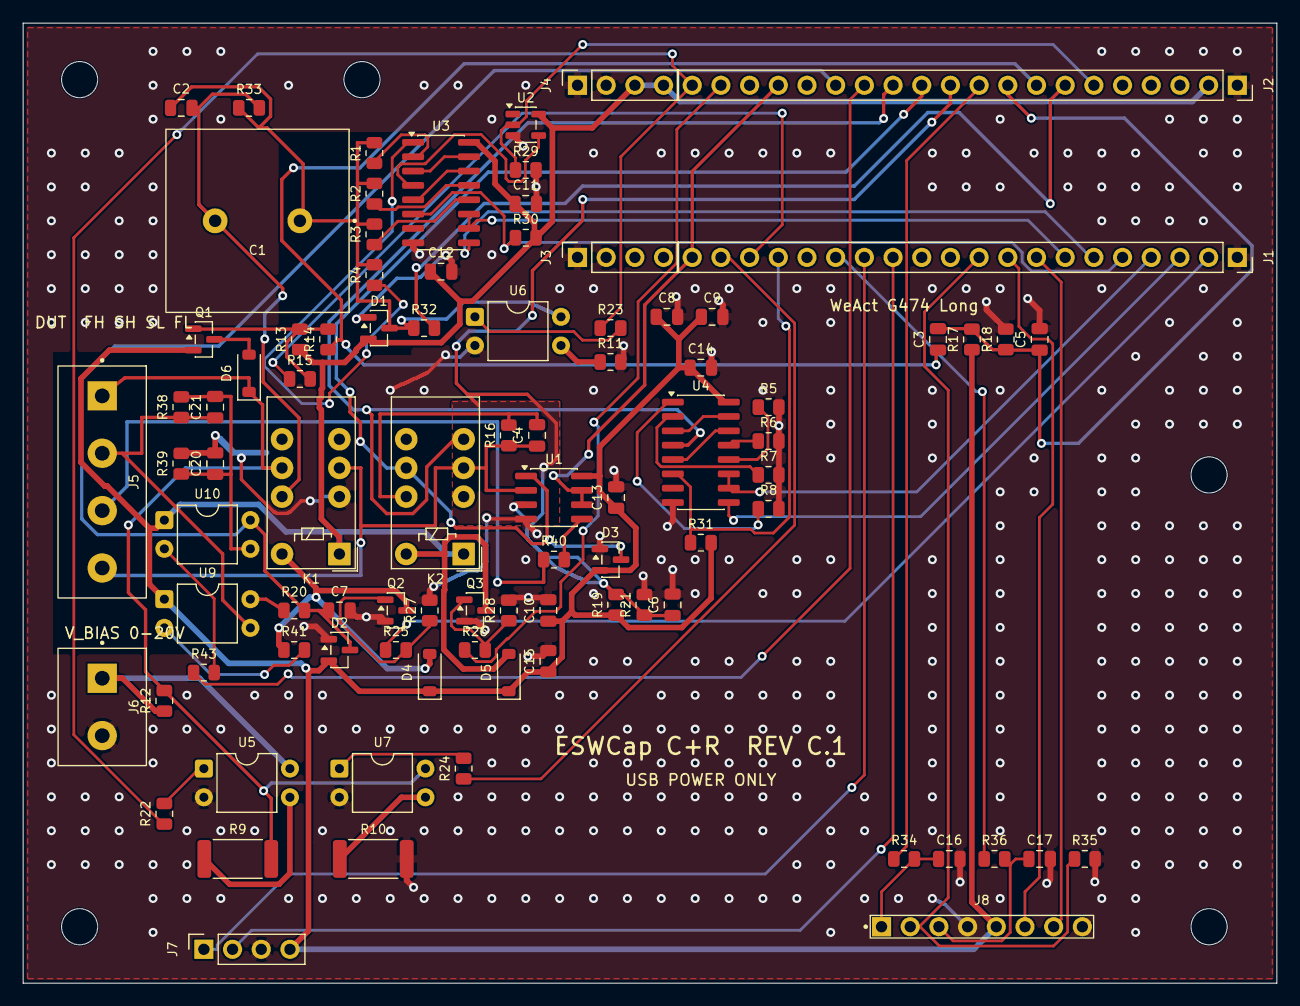
[picture p13: board Project.kicad_pcb from above]

Board: 2 copper layers, 111.0 x 85.0 mm, 93 parts (0 on the bottom side), 70 nets.

Other parts of the board:
H1, H2, H3, H4, H5: M3; MountingHole_3.2mm_M3
