JAGUARAVI/STMProject/(commit log)

2026-11-12 Initial commit: ESWCap STM32G474 port
2026-11-12 docs: add Rev C USB-only 4-wire C/R plan
2026-11-12 fix(c-mode): move COMP1 output/drive from PA8 to PA0, 70 mV hysteresis
    PA8 cannot carry COMP1_OUT on the STM32G474CEU6: ST's GPIO data
    (GPIO-STM32G47x_gpio_v1_0) gives PA8 AF8 = COMP7_OUT. COMP1_OUT exists
    only on PA0, PA6, PA11 and PB8. With PA8 the oscillator loop never
    closes, so the C-mode oscillator method could not work. PA6 is TIA_OUT,
    PA11 is USB and PB8 is BOOT0, so the drive pin moves to PA0 (WeAct P2-6,
    nothing else on the module per the V1.0 schematic).
    - config.h: PIN_DRIVE = PA0, PIN_DRIVE_AF = GPIO_AF8_COMP1
    - COMP1 hysteresis 20 mV -> 70 mV: 20 mV gave K ~= 0.024, below the
    solver's 0.05 gate, so cal1/cal2 would be refused. 70 mV gives
    K ~= 0.085; OSC_K_MIN lowered to 0.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
    [bsp_comp.c, bsp_comp.h, bsp_frontend.c, bsp_frontend.h, calib.c, config.h, osc_calc.c, rmode.c]
2026-11-12 hardware: add Rev C schematic, libraries and BOM
    [Project-bom.csv, Project-revC-routing-baseline.kicad_pcb, Project.kicad_sch]
2026-11-14 hardware: Rev C PCB layout, fab outputs and routing scripts; docs: circuit diagrams and accuracy plan
    [Project-B_Cu.gbl, Project-B_Mask.gbs, Project-B_Paste.gbp, Project-B_Silkscreen.gbo, Project-Edge_Cuts.gm1, Project-F_Cu.gtl, Project-F_Mask.gts, Project-F_Paste.gtp]
2026-11-14 docs: add build guide, wiring map and wire list with board export script
    [ESWCap-wire-list.csv]
